grobinson105/HeatSet-Home-Energy-Monitoring/(commit log)

2021-11-04 Rename READ ME.txt to Raspberry Pi Set Up ReadMe.txt
2021-11-23 Rename Raspberry Pi Set Up ReadMe.txt to 04_Raspberry Pi Set Up ReadMe.txt
